JuliusC4es4r/Intelligent-Tidal-Energy-Monitoring-System/README.md

# Intelligent Tidal Energy Monitoring System
 A standalone smart tidal energy monitoring system designed to harvest energy from solar power and tidal waves while intelligently optimizing itself for maximum power generation and efficiency.
