JuliusC4es4r/Intelligent-Tidal-Energy-Monitoring-System/PSpice/ECE 356 HARDWARE.png

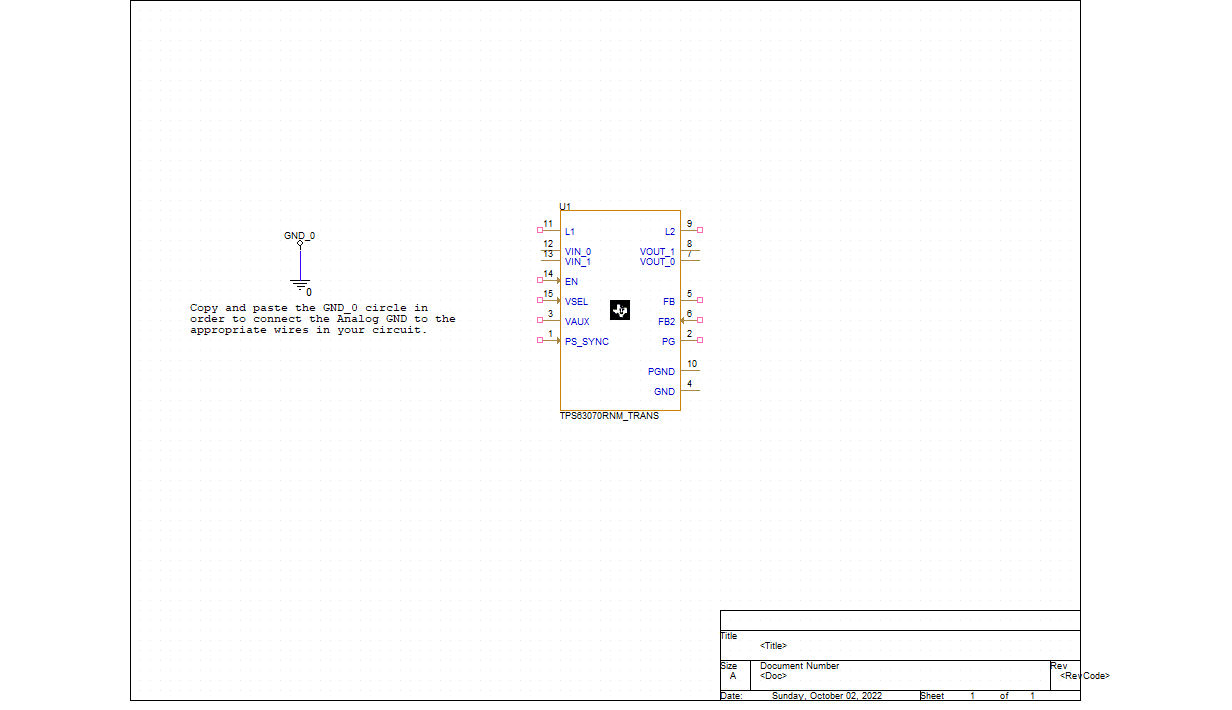
PSpice/ECE 356 HARDWARE.png
