JuliusC4es4r/Intelligent-Tidal-Energy-Monitoring-System/Electrical/Project Outputs for Intelligent Tidal Energy Monitoring System/BOM/BOM/Bill of Materials-Intelligent Tidal Energy Monitoring System(ITEMS PCBA Rev A).xlsx

Comment | Description | Designator | Footprint | LibRef | Quantity | Fitted
54 | Cylindrical Battery Contacts, Clips, Holders & Springs 16-19mm PC BATTERY CLIP | BT300 | FP-54-MFG | CMP-00051-1 | 1
0.1 µF | CAP CER 0.1UF 25V X7R 0603, CAP CER 0.1UF 50V X7R 0603 | C200, C201, C300, C301, C306, C310, C311, C402, C403 | CAP 0603_1608 | C0603X104M3RAC7867, C0603C104K5RAC7411 | 9
10 µF | CAP CER 10UF 25V X5R 0603 | C302, C303, C304, C307 | CAP 0603_1608 | GRM188R61E106MA73J | 4
22 µF | CAP CER 22UF 16V X5R 0805 | C305, C308, C309 | CAP 0805_2012 | CL21A226MOQNNNE | 3
0.022 µF | CAP CER 0.022UF 16V X7R 0603 | C400, C401 | CAP 0603_1608 | CC0603KRX7R7BB223 | 2
RBR2MM40CTFTR | DIODE (RECTIFIER FRD) 40V-VR 2A- | D300 | SOD123F | RBR2MM40CTFTR | 1
Green | LED GREEN CLEAR 2SMD | D301, D302 | LED 0603_1608 GREEN | XZVGT53W-6 | 2
LMV601MGX/NOPB | IC OPAMP GP 1 CIRCUIT SC70-6 | IC400, IC401 | TI SC70-6 DCK | LMV601MGX/NOPB | 2
B2B-XH-A(LF)(SN) | CONN HEADER VERT 2POS 2.5MM | J300 | JST XH B2B-XH-A | B2B-XH-A(LF)(SN) | 1
B3B-XH-A(LF)(SN) | CONN HEADER VERT 3POS 2.5MM | J400 | JST XH B3B-XH-A | B3B-XH-A(LF)(SN) | 1
GY-GPS6MV2 | NEO-6M GPS Module | J401 | GY-GPS6MV2 -Footprint-1 | CMP-00056-2 | 1
1.5µH | FIXED IND 1.5UH 1.5A 70 MOHM SMD | L300 | IND 1008_2520 | CVH252009-1R5M | 1
Exposed Mounting Hole M3 | M3 Mounting Hole Exposed | MH100, MH101, MH102, MH103 | Mounting Hole M3-Footprint-1 | CMP-00028-00002-1 | 4
BSS314PE | P-Channel OptiMOS P3 Small-Signal-Transistor, -30 V VDS, -1.5 A ID, -55 to 150 degC, PG-SOT23, Reel, Green | Q300 | INF-PG-SOT23_N | CMP-1099-00027-1 | 1
BSS126 | N-Channel SIPMOS Small-Signal-Transistor, 600 V VDS, 0.021 A ID, -55 to 150 degC, PG-SOT23, Reel, Green | Q301, Q302 | INF-PG-SOT23_L | CMP-1153-00007-1 | 2
10 kOhms | RES SMD 10K OHM 1% 1/10W 0603 | R200, R201, R302, R303, R305, R400 | RES 0603_1608 | RT0603FRE0710KL | 6
0 Ohms | RES 0 OHM JUMPER 1/10W 0603 | R300, R301 | RES 0603_1608 | PA0603-R-070RL | 2
300 kOhms | RES 300K OHM 1% 1/10W 0603 | R304 | RES 0603_1608 | RC0603FR-07300KL | 1
51 kOhms | RES SMD 51K OHM 1% 1/10W 0603 | R306 | RES 0603_1608 | CRCW060351K0FKEA | 1
3.3 kOhms | RES 3.3K OHM 1% 1/4W 0603 | R307 | RES 0603_1608 | CRGP0603F3K3 | 1
47k | THERMISTOR NTC 47KOHM 4050K 0603 | R308 | NTC 0603_1608 | NCP18WB473F10RB | 1
1 kOhms | RES SMD 1K OHM 1% 1/10W 0603 | R309, R310 | RES 0603_1608 | RT0603FRE071KL | 2
17.4 kOhms | RES 17.4K OHM 1% 1/10W 0603 | R401 | RES 0603_1608 | RC0603FR-0717K4L | 1
33 kOhms | RES SMD 33K OHM 1% 1/10W 0603 | R402, R403 | RES 0603_1608 | RT0603FRE0733KL | 2
1977223-9 | SWITCH TACTILE SPST-NO 0.05A 24V | S200, S201 | TE FSM4JSMA | 1977223-9 | 2
Rocker Switch | 12mm x 18.5mm Rocker Switch 6A 250VAC | S300, S301 | Rocker Switch-Footprint-1 | CMP-00054-3 | 2
1.5mm Test Point | 1.5mm Test Point 0.75mm hole size | TP200, TP303, TP304, TP305, TP306, TP400, TP401, TP402, TP403, TP404, TP405, TP406 | 1mm Test Point-Footprint-1 | CMP-002-00006-1 | 12
S2751-46R | Conn Test Point 1 POS Solder ST SMD 1 Port T/R | TP300, TP301, TP302, TP307 | FP-S2751-46R-MFG | CMP-00053-4 | 4
SC0918 | Raspberry Pi Pico W | U200 | New footprint 1 | CMP-00055-1 | 1
BQ25050DQCR | 1 A, Single-Input, Single Cell Li-Ion Battery Charger with 50 mA LDO, -40 to 85 degC, 10-pin WSON (DQC), Green (RoHS & no Sb/Br) | U300 | DQC0010A | CMP-0321-00476-2 | 1
TPS63070RNMR | IC REG BCK BST ADJ 3.6A 15VQFN | U301 | FP-RNM0015A-MFG | CMP-04918-000409-1 | 1
