JuliusC4es4r/Intelligent-Tidal-Energy-Monitoring-System/Mechanical/ITEMS Flow Sensor Assembly.SLDASM

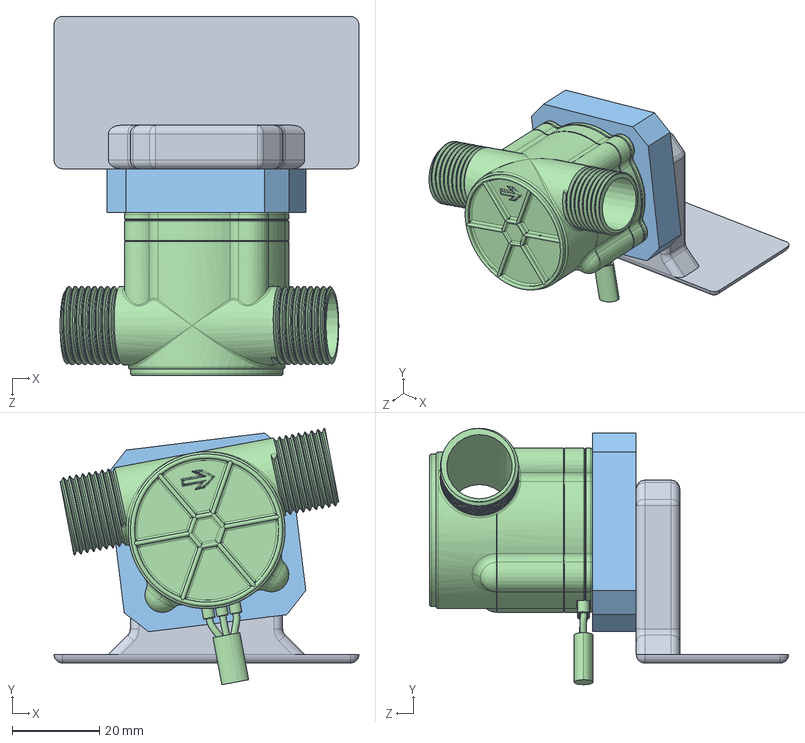
[picture p2: CAD file, 2022-11-04]
Mechanical/ITEMS Flow Sensor Assembly.SLDASM
70.0 x 58.9 x 82.5 mm
5972K222_Ball Bearing
Flow Sensor RotatorSLDPRT
Water Flow Sensor.STEP
pan cross head_ai_CR-PHMS 0.112-48x0.375x0.375-S.STEP x 4
