JuliusC4es4r/Intelligent-Tidal-Energy-Monitoring-System/Mechanical/ITEMS PCBA.SLDASM

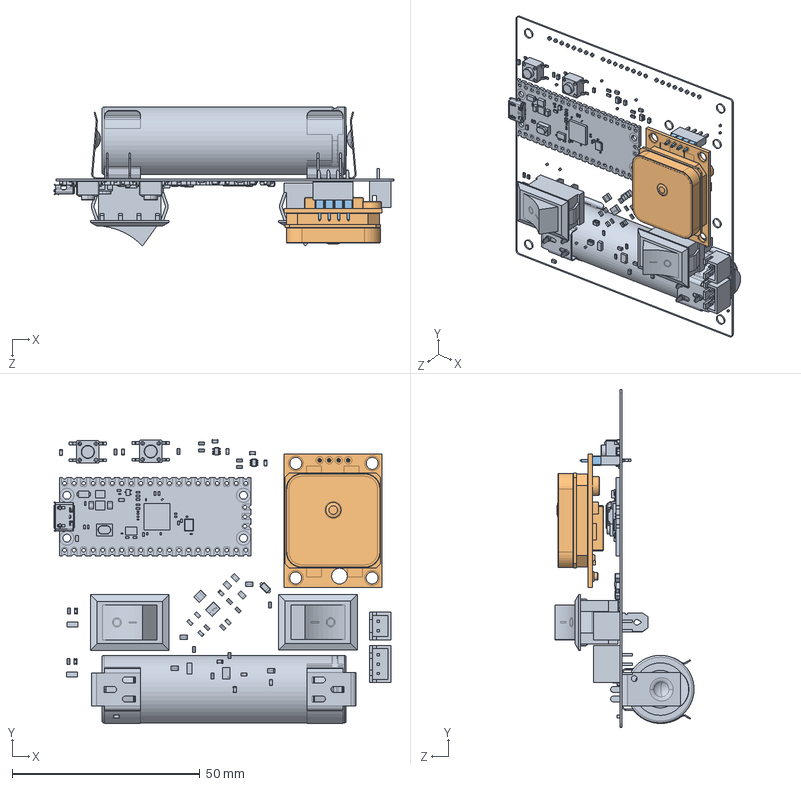
[picture p3: CAD file, 2022-10-14]
Mechanical/ITEMS PCBA.SLDASM
90.5 x 90.0 x 37.0 mm
ITEMS PCB Rev A
A_GPS_main
4-Pin Header - Male - 2.54mm.step
