JuliusC4es4r/Intelligent-Tidal-Energy-Monitoring-System/Mechanical/ITEMS Assembly.SLDASM

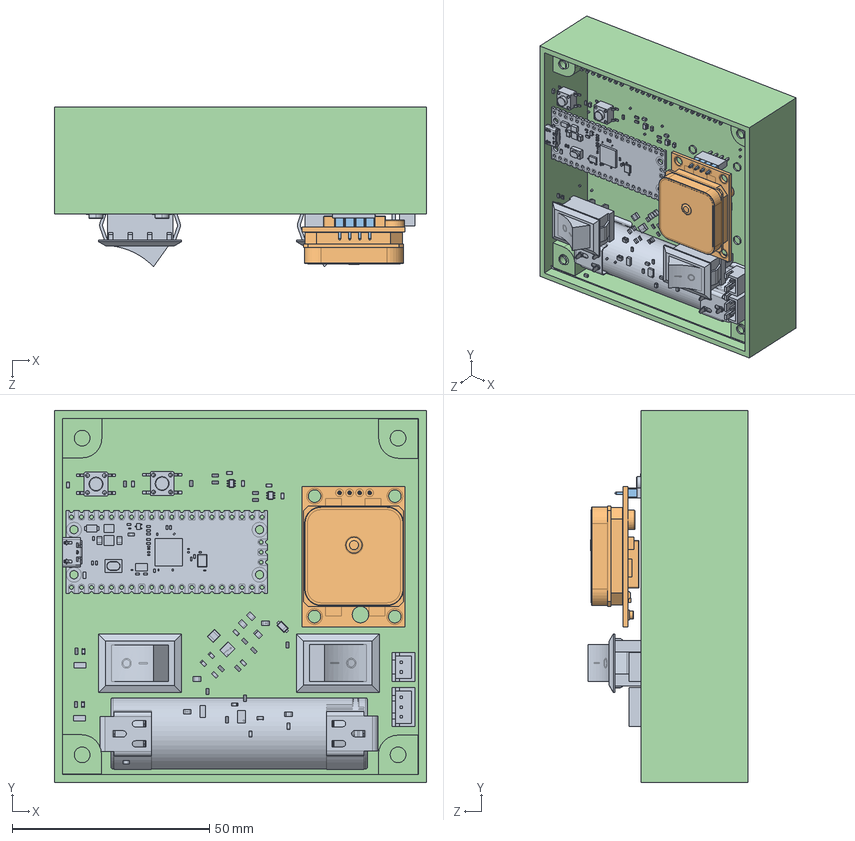
[picture p4: CAD file, 2022-10-13]
Mechanical/ITEMS Assembly.SLDASM
94.2 x 94.2 x 40.4 mm
ITEMS PCB Rev A
A_GPS_main
4-Pin Header - Male - 2.54mm.step
ITEMS Bottom Case
