JuliusC4es4r/Intelligent-Tidal-Energy-Monitoring-System/Mechanical/A_GPS_main.SLDPRT

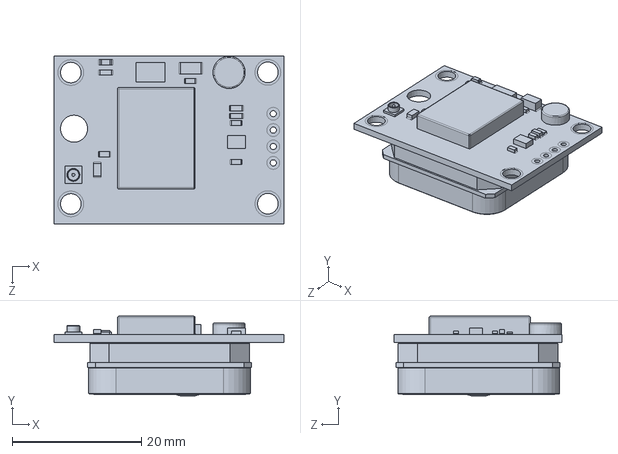
[picture p5: CAD file, 2022-10-07]
Mechanical/A_GPS_main.SLDPRT
35.6 x 12.3 x 26.1 mm
