JuliusC4es4r/Intelligent-Tidal-Energy-Monitoring-System/Mechanical/Flow Sensor RotatorSLDPRT.SLDPRT

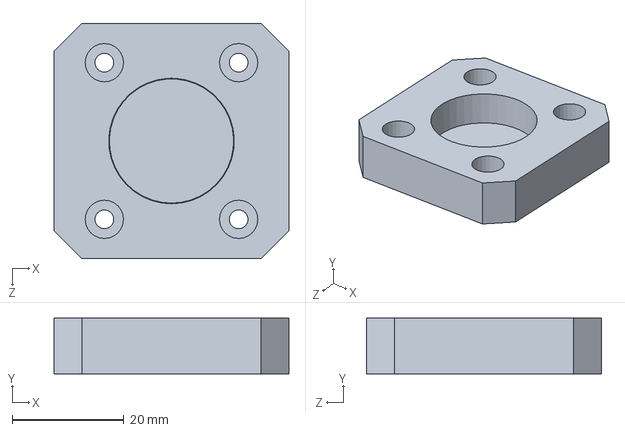
[picture p6: CAD file, 2022-11-06]
Mechanical/Flow Sensor RotatorSLDPRT.SLDPRT
42.0 x 10.0 x 42.0 mm
