JuliusC4es4r/Intelligent-Tidal-Energy-Monitoring-System/Mechanical/Flow Sensor Mount.SLDPRT

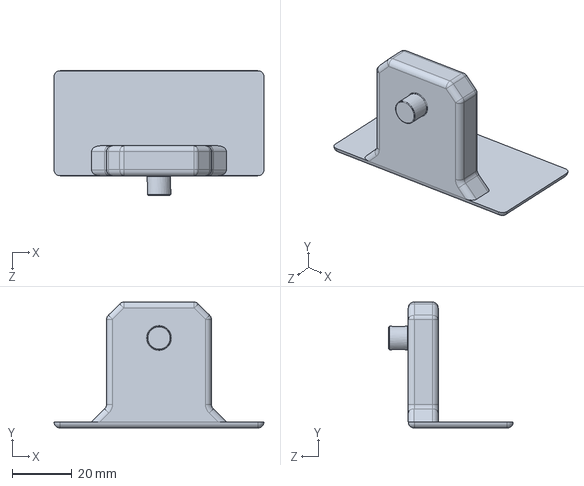
[picture p7: CAD file, 2022-11-04]
Mechanical/Flow Sensor Mount.SLDPRT
70.0 x 42.0 x 41.5 mm
