JuliusC4es4r/Intelligent-Tidal-Energy-Monitoring-System/Mechanical/Plexiglass Cutout 85mm squared.SLDPRT

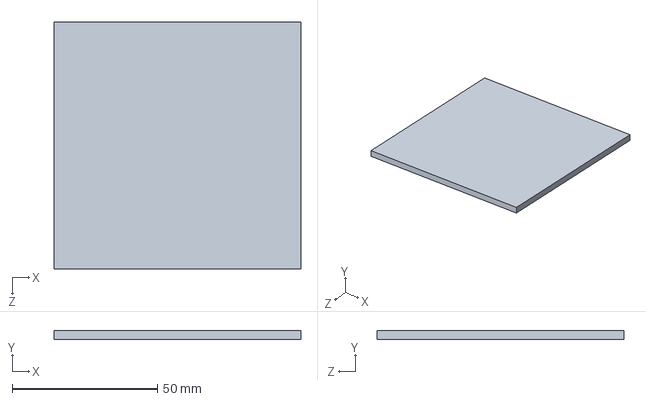
[picture p8: CAD file, 2022-11-04]
Mechanical/Plexiglass Cutout 85mm squared.SLDPRT
85.0 x 3.00 x 85.0 mm
