JuliusC4es4r/Intelligent-Tidal-Energy-Monitoring-System/Mechanical/ITEMS Bottom Case.SLDPRT

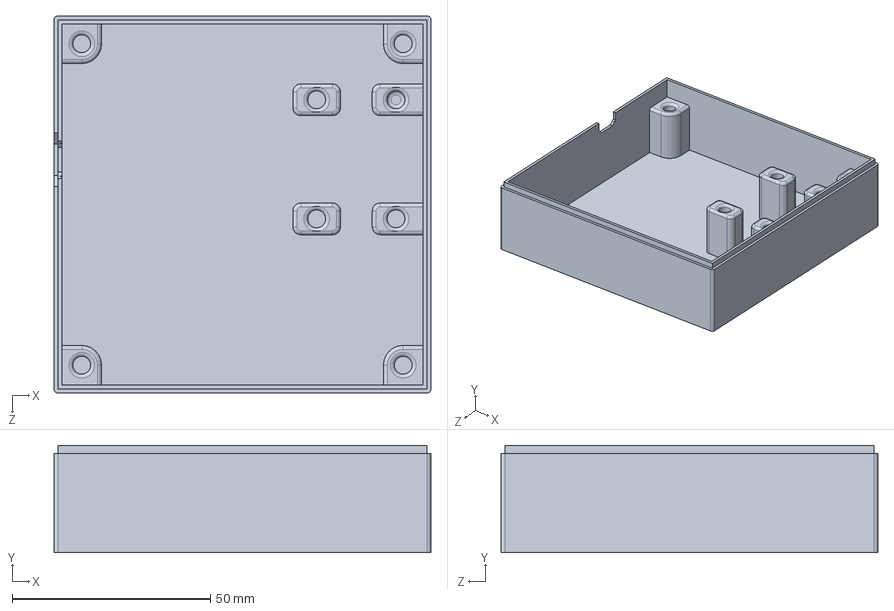
[picture p9: CAD file, 2022-11-04]
Mechanical/ITEMS Bottom Case.SLDPRT
95.0 x 27.0 x 95.0 mm
