JuliusC4es4r/Intelligent-Tidal-Energy-Monitoring-System/Mechanical/ITEMS Top Case.SLDPRT

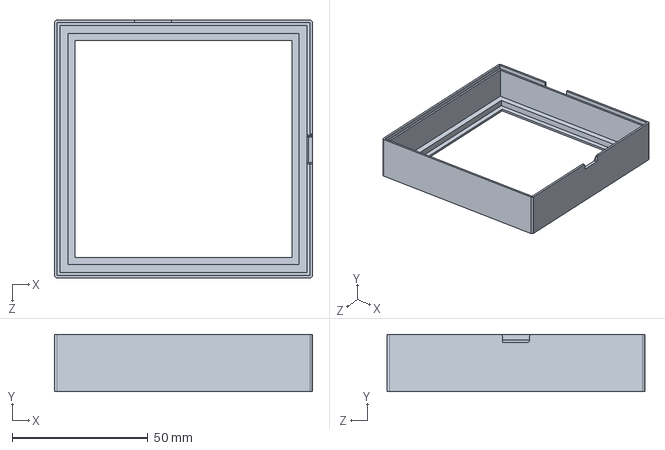
[picture p10: CAD file, 2022-11-04]
Mechanical/ITEMS Top Case.SLDPRT
95.0 x 21.0 x 95.0 mm
