JuliusC4es4r/Intelligent-Tidal-Energy-Monitoring-System/Mechanical/Water Flow sensor.STEP

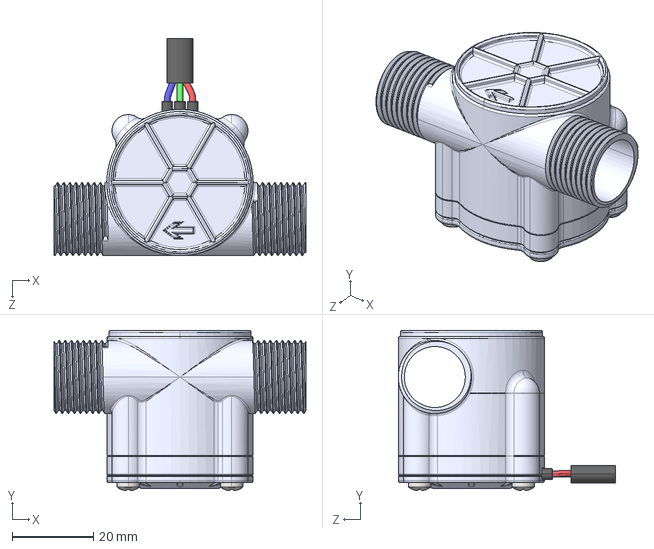
[picture p11: CAD file, 2022-11-04]
Mechanical/Water Flow sensor.STEP
62.0 x 39.5 x 53.5 mm
Water Flow Sensor
pan cross head_ai_CR-PHMS 0.112-48x0.375x0.375-S x 4
