JuliusC4es4r/Intelligent-Tidal-Energy-Monitoring-System/Mechanical/Solar Panel.SLDPRT

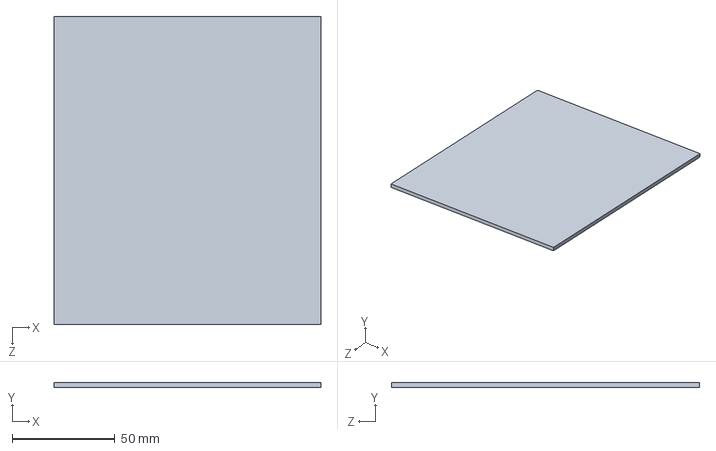
[picture p12: CAD file, 2022-10-13]
Mechanical/Solar Panel.SLDPRT
130.0 x 2.50 x 150.0 mm
