JuliusC4es4r/Intelligent-Tidal-Energy-Monitoring-System/Mechanical/4-Pin Header - Female - 2.54mm.step

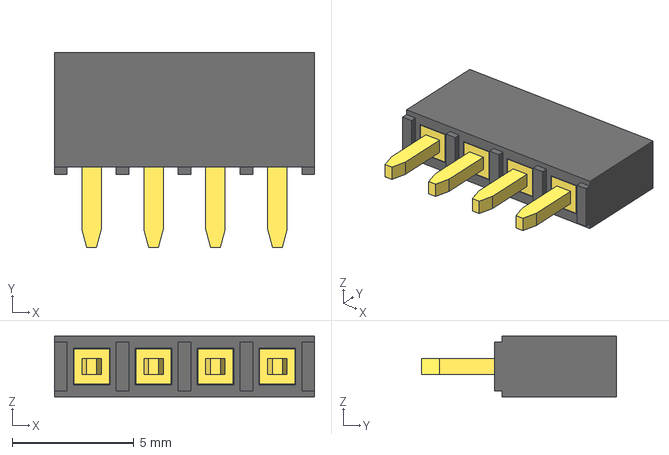
[picture p13: CAD file, 2022-10-07]
Mechanical/4-Pin Header - Female - 2.54mm.step
10.7 x 8.00 x 2.50 mm
