JuliusC4es4r/Intelligent-Tidal-Energy-Monitoring-System/Mechanical/4-Pin Header - Male - 2.54mm.step

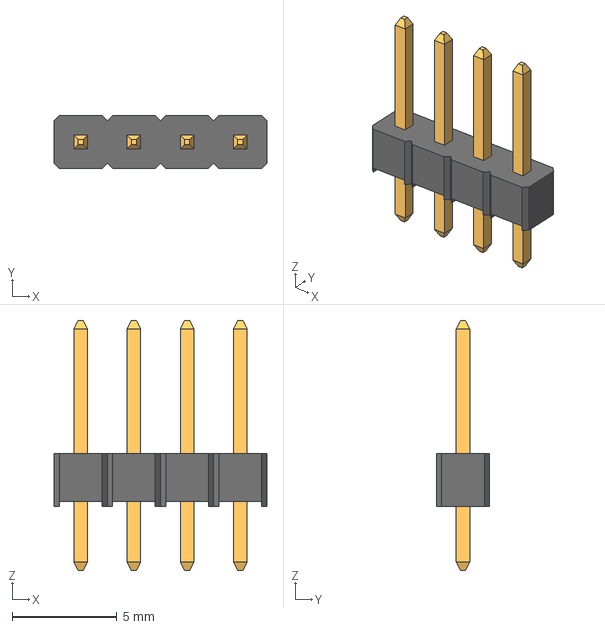
[picture p14: CAD file, 2022-10-07]
Mechanical/4-Pin Header - Male - 2.54mm.step
10.2 x 2.54 x 11.9 mm
