JuliusC4es4r/Intelligent-Tidal-Energy-Monitoring-System/Mechanical/5972K222_Ball Bearing.SLDPRT

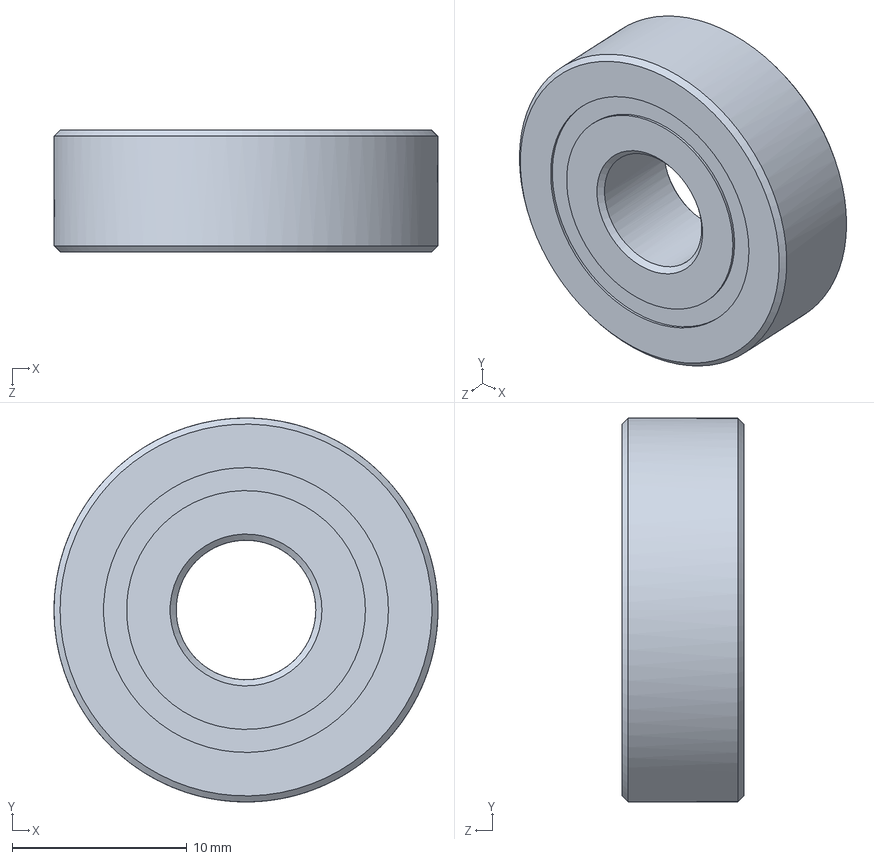
[picture p15: CAD file, 2022-11-04]
Mechanical/5972K222_Ball Bearing.SLDPRT
22.0 x 22.0 x 7.00 mm
