JuliusC4es4r/Intelligent-Tidal-Energy-Monitoring-System/Mechanical/91290A111_Alloy Steel Socket Head Screw.SLDPRT

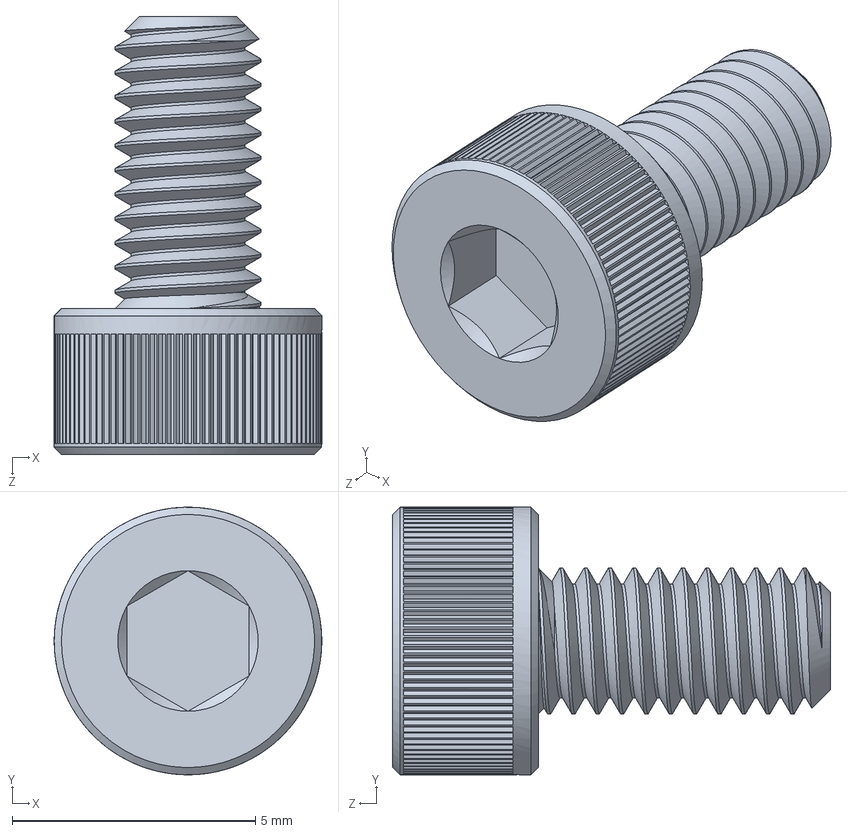
[picture p16: CAD file, 2022-10-14]
Mechanical/91290A111_Alloy Steel Socket Head Screw.SLDPRT
5.50 x 5.50 x 9.00 mm
