JuliusC4es4r/Intelligent-Tidal-Energy-Monitoring-System/Mechanical/94459A140_Heat-Set Inserts for Plastic (1).SLDPRT

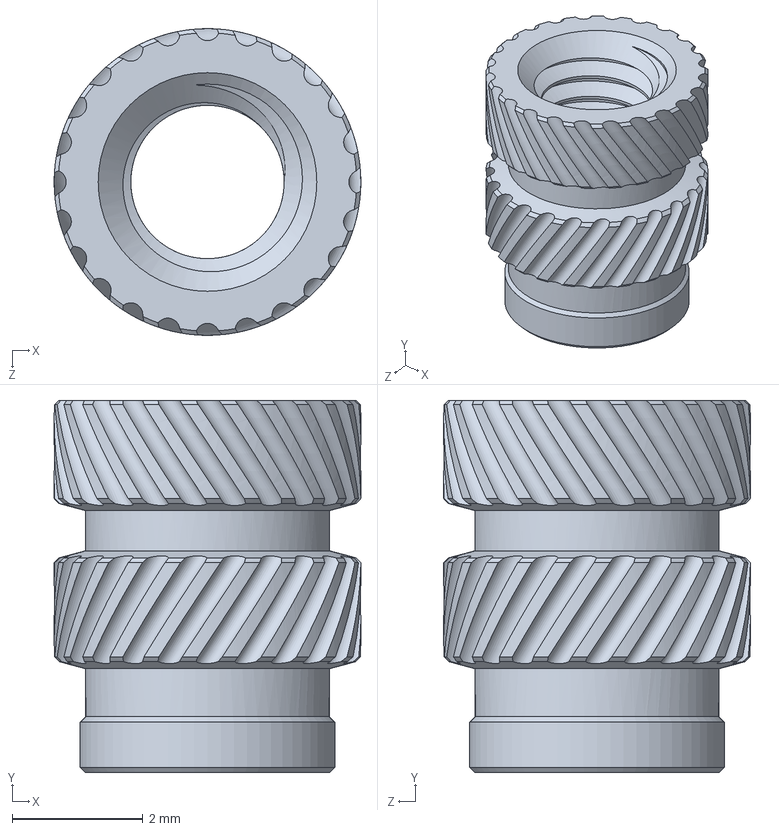
[picture p17: CAD file, 2022-10-14]
Mechanical/94459A140_Heat-Set Inserts for Plastic (1).SLDPRT
4.70 x 5.70 x 4.70 mm
