JuliusC4es4r/Intelligent-Tidal-Energy-Monitoring-System/(list of files, cad)

Other CAD files:
Mechanical/Flow Sensor Mount.STL
Mechanical/Flow Sensor RotatorSLDPRT.STL
Mechanical/ITEMS Bottom Case.STL
Mechanical/ITEMS Top Case.STL
