JuliusC4es4r/Intelligent-Tidal-Energy-Monitoring-System/Electrical/Intelligent Tidal Energy Monitoring System.pdf

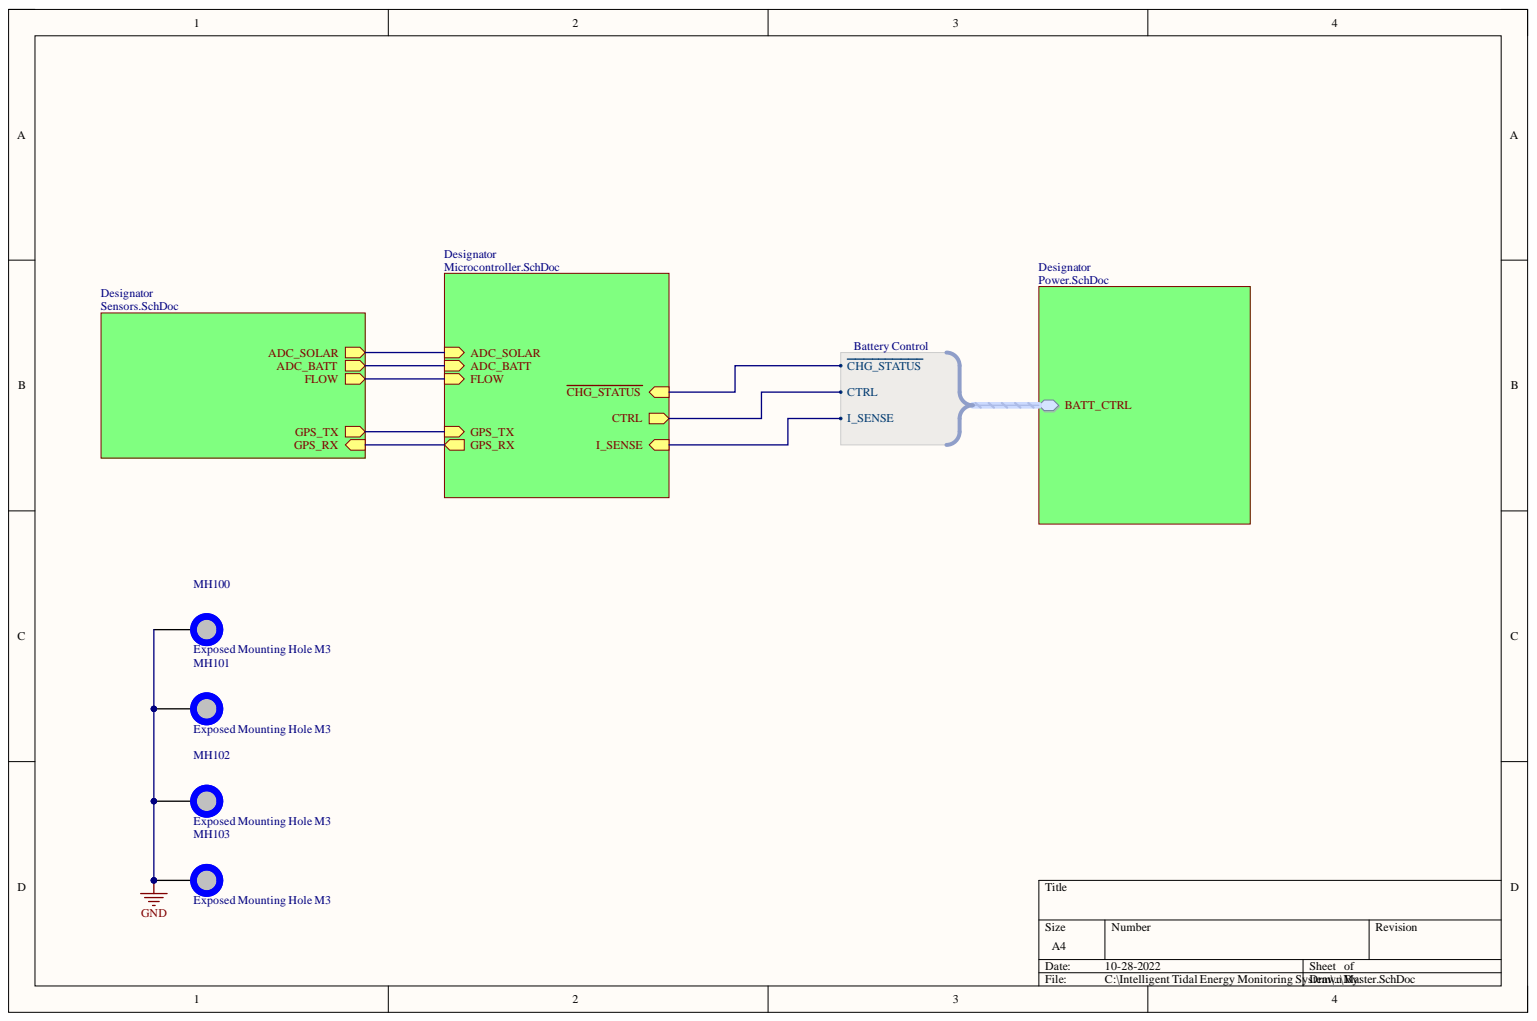
[picture p18: page 1]

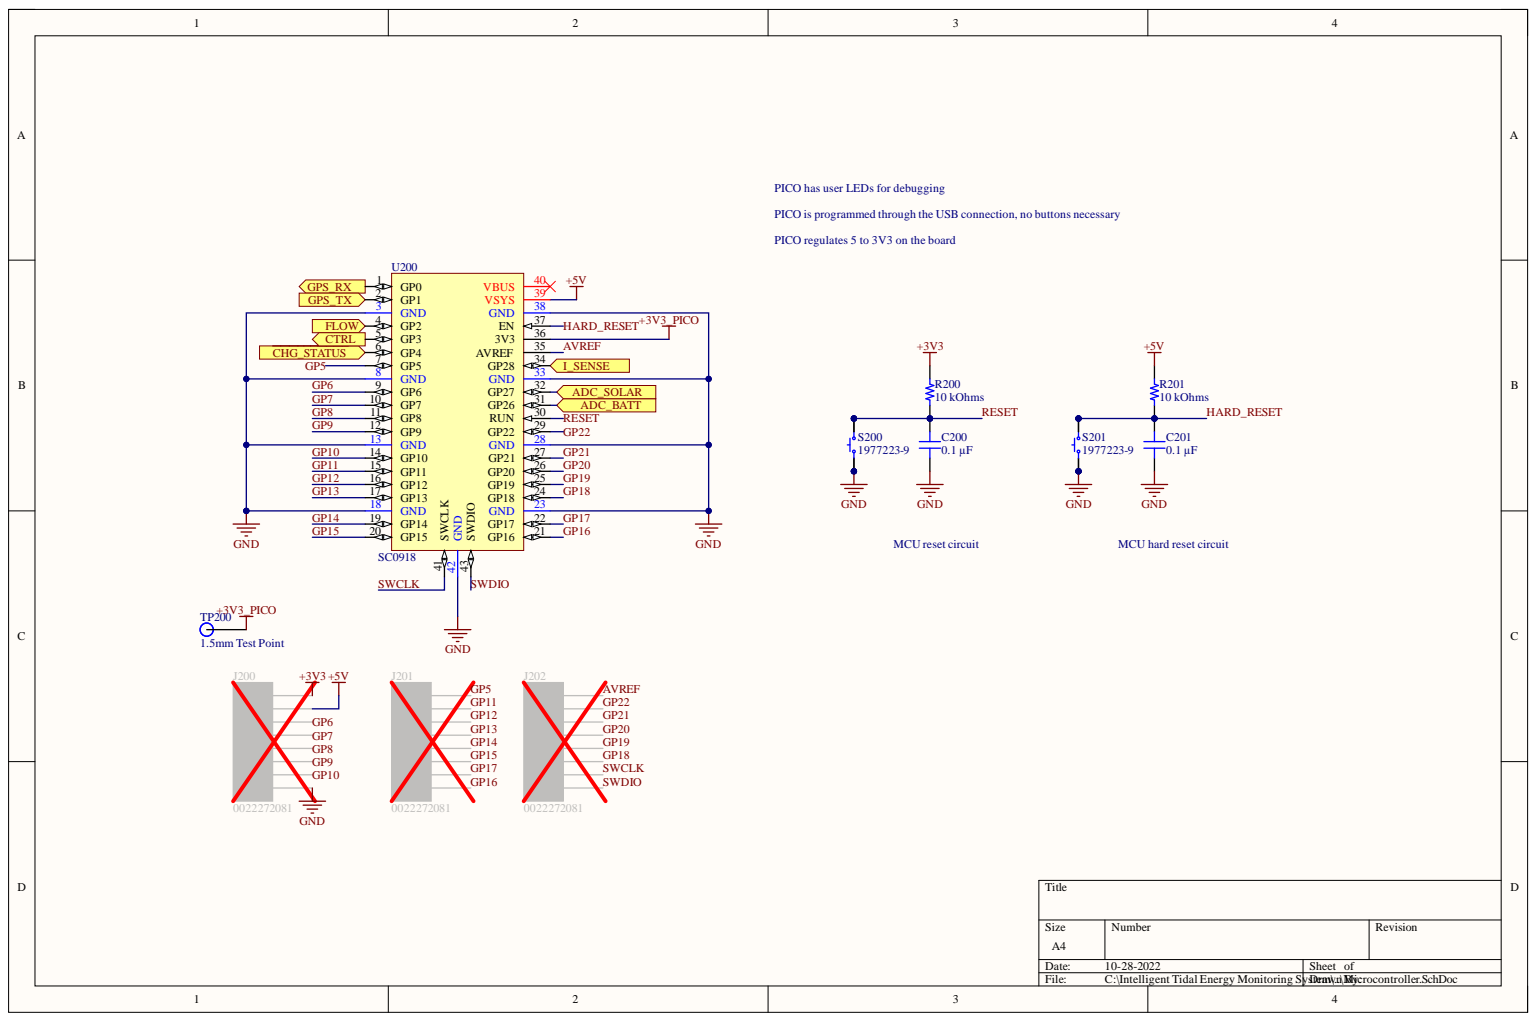
[picture p19: page 2]

FL O W CTRL CH G_ST AT | 4 | VA 3 7 +3 V 3 _PI C O

5 | 3 6
6 | 3 5 AV RE F I_SE N S E

1 2 | | 2
1 3 | | 2 8

sDtem\ raw..\nMi Bycro : co

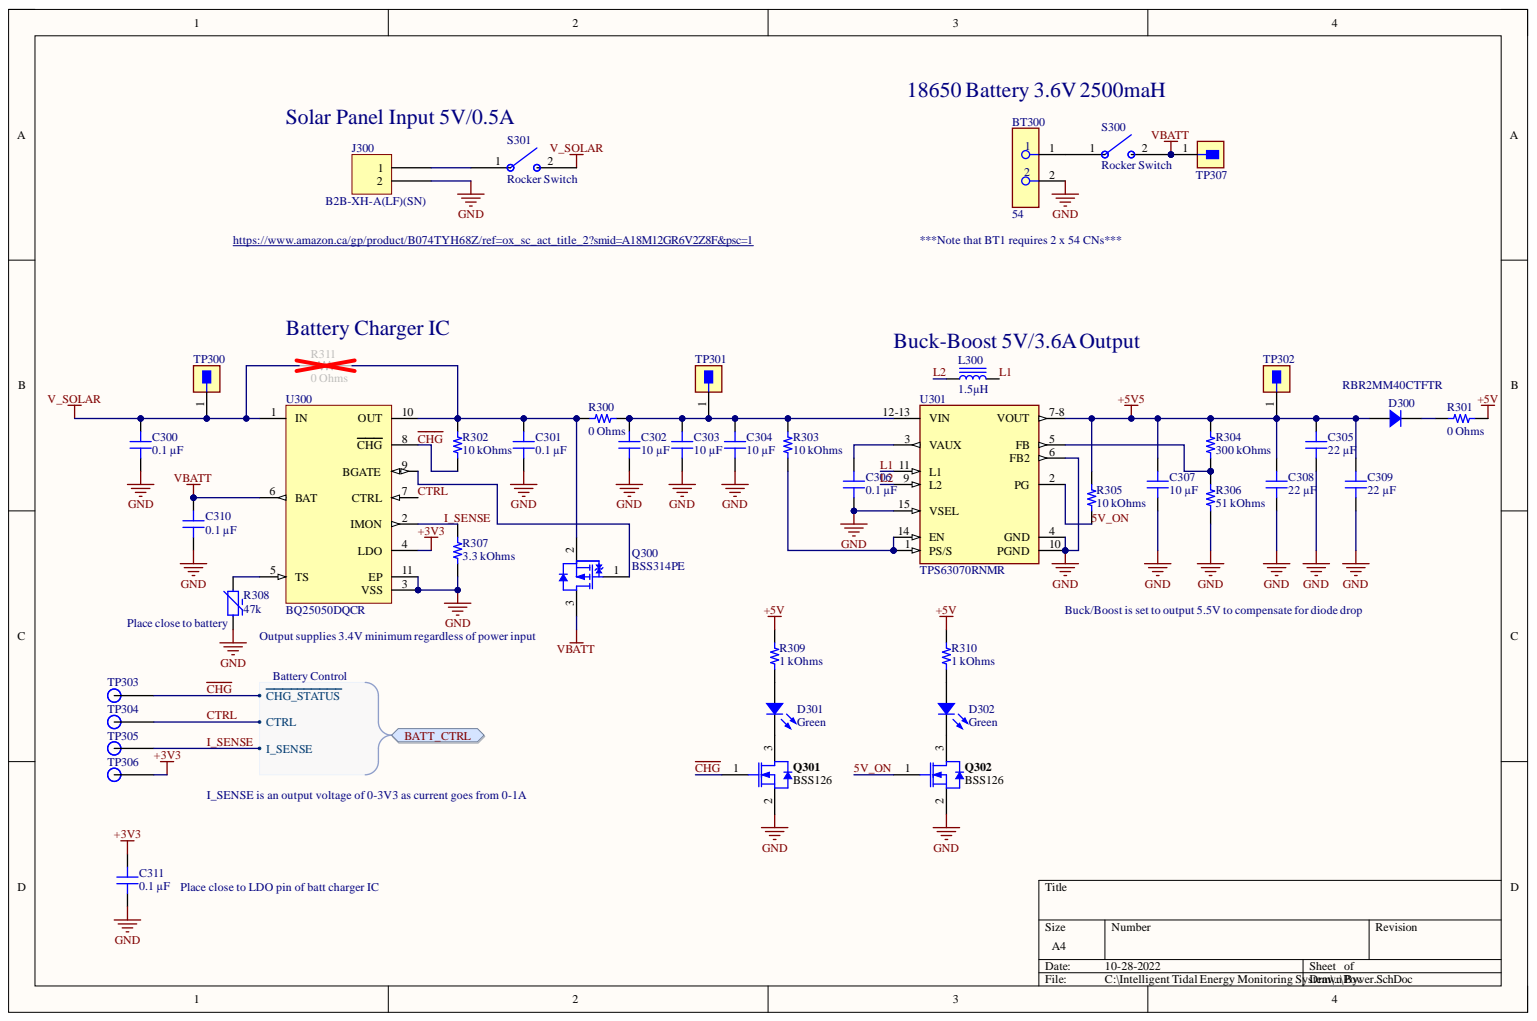
[picture p20: page 3]

https://www.amazon.ca/gp/product/B074TYH68Z/ref=ox_sc_act_title_2?smid=A18M12GR6V2Z8F&psc=1

***Note that BT1 requires 2 x 54 CNs***

Buck/Boost is set to output 5.5V to compensate for diode drop

Place close to battery

Output supplies 3.4V minimum regardless of power input

I_SENSE is an output voltage of 0-3V3 as current goes from 0-1A

Place close to LDO pin of batt charger IC

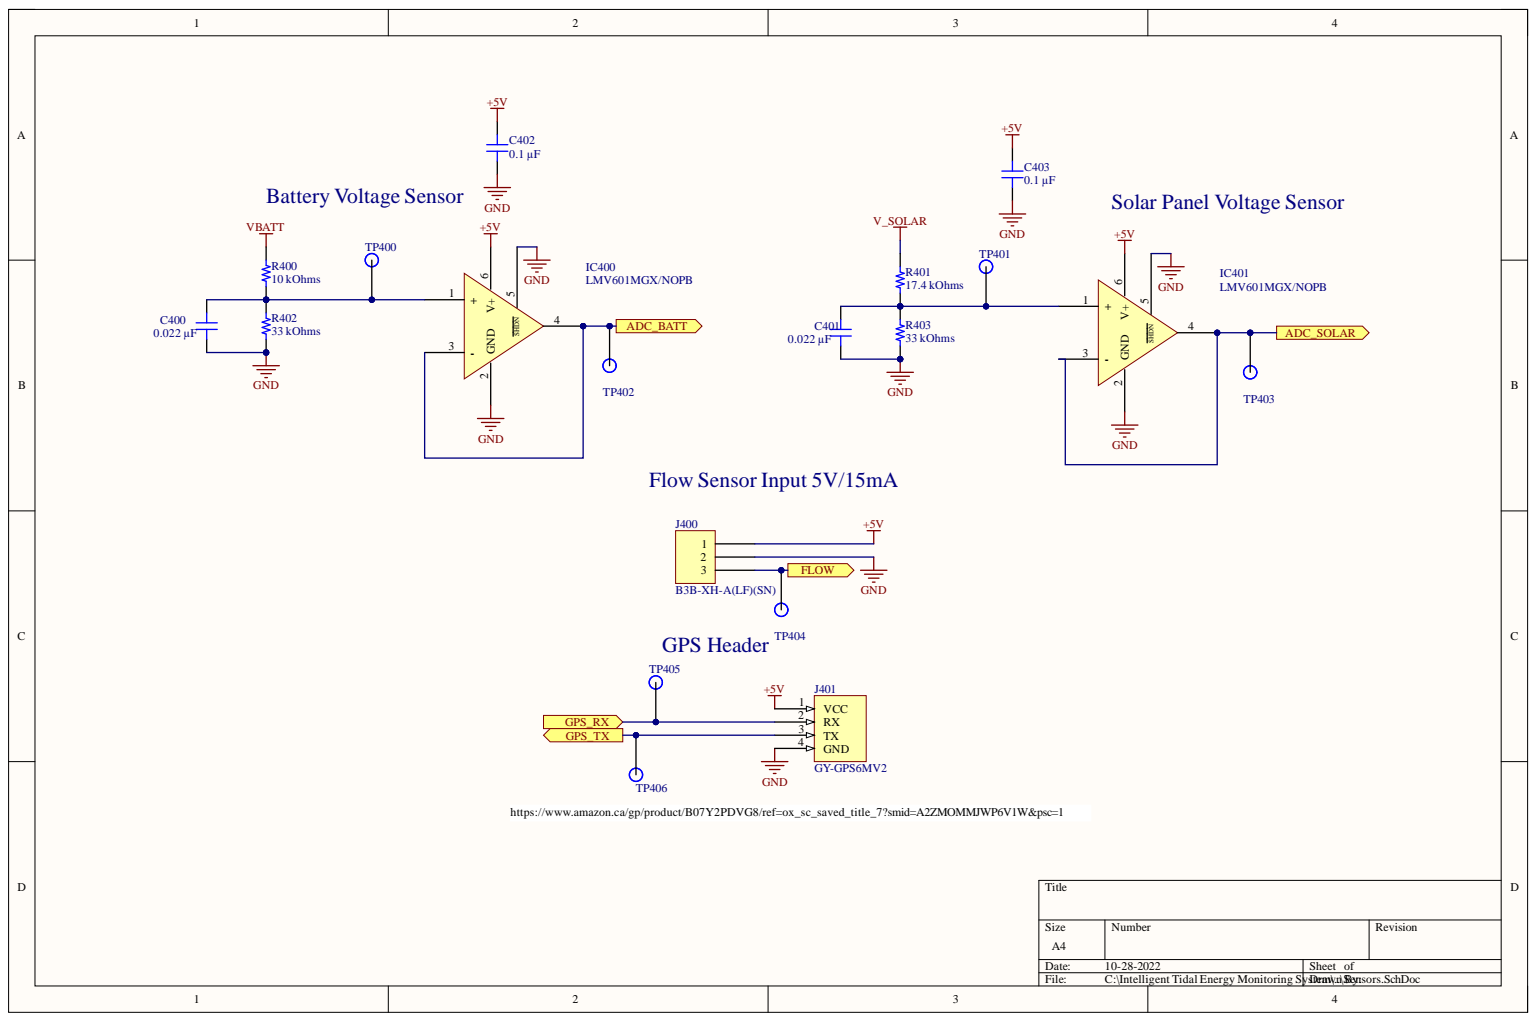
[picture p21: page 4]

Solar Panel Voltage Sensor

https://www.amazon.ca/gp/product/B07Y2PDVG8/ref=ox_sc_saved_title_7?smid=A2ZMOMMJWP6V1W&psc=1

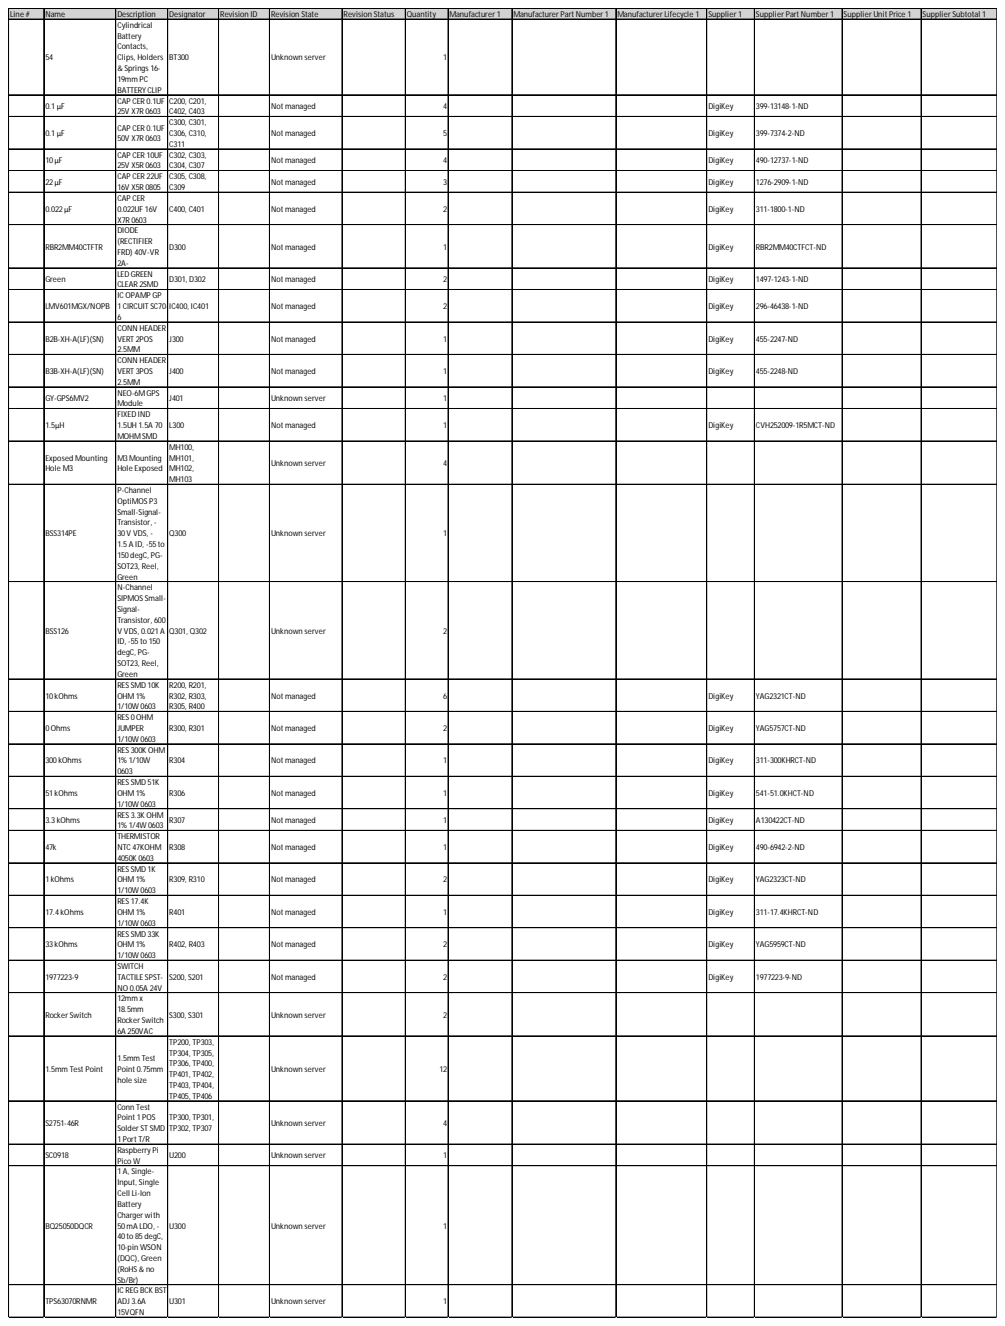
[picture p22: page 5]

Line # | Name | Description | Designator | Revision ID | Revision State | Revision Status | Quantity | Manufacturer 1 | Manufacturer Part Number 1 | Manufacturer Lifecycle 1 | Supplier 1 | Supplier Part Number 1 | Supplier Unit Price 1 | Supplier Subtotal 1

Cylindrical Battery Contacts, Clips, Holders & Springs 16-19mm PC BATTERY CLIP | BT300 | | Unknown server | | | 1

0.1 µF | CAP CER 0.1UF 25V X7R 0603 | C200, C201, C402, C403 | | Not managed | | | 4 | | | DigiKey | 399-13148-1-ND

0.1 µF | CAP CER 0.1UF 50V X7R 0603 | C300, C301, C306, C310, C311 | | Not managed | | | 5 | | | DigiKey | 399-7374-2-ND

10 µF | CAP CER 10UF 25V X5R 0603 | C302, C303, C304, C307 | | Not managed | | | 4 | | | DigiKey | 490-12737-1-ND

22 µF | CAP CER 22UF 16V X5R 0805 | C305, C308, C309 | | Not managed | | | 3 | | | DigiKey | 1276-2909-1-ND

0.022 µF | CAP CER 0.022UF 16V X7R 0603 | C400, C401 | | Not managed | | | 2 | | | DigiKey | 311-1800-1-ND

RBR2MM40CTFTR | DIODE (RECTIFIER FRD) 40V-VR 2A- | D300 | | Not managed | | | 1 | | | DigiKey | RBR2MM40CTFCT-ND

Green | LED GREEN CLEAR 2SMD | D301, D302 | | Not managed | | | 2 | | | DigiKey | 1497-1243-1-ND

LMV601MGX/NOPB | IC OPAMP GP 1 CIRCUIT SC70-6 | IC400, IC401 | | Not managed | | | 2 | | | DigiKey | 296-46438-1-ND

B2B-XH-A(LF)(SN) | CONN HEADER VERT 2POS 2.5MM | J300 | | Not managed | | | 1 | | | DigiKey | 455-2247-ND

B3B-XH-A(LF)(SN) | CONN HEADER VERT 3POS 2.5MM | J400 | | Not managed | | | 1 | | | DigiKey | 455-2248-ND

GY-GPS6MV2 | NEO-6M GPS Module | J401 | | Unknown server | | | 1

1.5µH | FIXED IND 1.5UH 1.5A 70 MOHM SMD | L300 | | Not managed | | | 1 | | | DigiKey | CVH252009-1R5MCT-ND

Exposed Mounting Hole M3 | M3 Mounting Hole Exposed | MH100, MH101, MH102, MH103 | | Unknown server | | | 4

BSS314PE | P-Channel OptiMOS P3 Small-Signal-Transistor, -30 V VDS, -1.5 A ID, -55 to 150 degC, PG-SOT23, Reel, Green | Q300 | | Unknown server | | | 1

BSS126 | N-Channel SIPMOS Small-Signal-Transistor, 600 V VDS, 0.021 A ID, -55 to 150 degC, PG-SOT23, Reel, Green | Q301, Q302 | | Unknown server | | | 2

10 kOhms | RES SMD 10K OHM 1% 1/10W 0603 | R200, R201, R302, R303, R305, R400 | | Not managed | | | 6 | | | DigiKey | YAG2321CT-ND

0Ohms | RES 0OHM JUMPER 1/10W 0603 | R300, R301 | | Not managed | | | 2 | | | DigiKey | YAG5757CT-ND

300 kOhms | RES 300K OHM 1% 1/10W 0603 | R304 | | Not managed | | | 1 | | | DigiKey | 311-300KHRCT-ND

51 kOhms | RES SMD 51K OHM 1% 1/10W 0603 | R306 | | Not managed | | | 1 | | | DigiKey | 541-51.0KHCT-ND

3.3 kOhms | RES 3.3K OHM 1% 1/4W 0603 | R307 | | Not managed | | | 1 | | | DigiKey | A130422CT-ND

47k | THERMISTOR NTC 47KOHM 4050K 0603 | R308 | | Not managed | | | 1 | | | DigiKey | 490-6942-2-ND

1 kOhms | RES SMD 1K OHM 1% 1/10W 0603 | R309, R310 | | Not managed | | | 2 | | | DigiKey | YAG2323CT-ND

17.4 kOhms | RES 17.4K OHM 1% 1/10W 0603 | R401 | | Not managed | | | 1 | | | DigiKey | 311-17.4KHRCT-ND

33 kOhms | RES SMD 33K OHM 1% 1/10W 0603 | R402, R403 | | Not managed | | | 2 | | | DigiKey | YAG5959CT-ND

1977223-9 | SWITCH TACTILE SPST-NO 0.05A 24V | S200, S201 | | Not managed | | | 2 | | | DigiKey | 1977223-9-ND

Rocker Switch | 12mm x 18.5mm Rocker Switch 6A 250VAC | S300, S301 | | Unknown server | | | 2

1.5mm Test Point | 1.5mm Test Point 0.75mm hole size | TP200, TP303, TP304, TP305, TP306, TP400, TP401, TP402, TP403, TP404, TP405, TP406 | | Unknown server | | 12

S2751-46R | Conn Test Point 1 POS Solder ST SMD 1 Port T/R | TP300, TP301, TP302, TP307 | | Unknown server | | | 4

SC0918 | Raspberry Pi Pico W | U200 | | Unknown server | | | 1

BQ25050DQCR | 1 A, Single-Input, Single Cell Li-Ion Battery Charger with 50mA LDO, -40 to 85 degC, 10-pin WSON (DQC), Green (RoHS & no Sb/Br) | U300 | | Unknown server | | | 1

TPS63070RNMR | IC REG BCK BST ADJ 3.6A 15VQFN | U301 | | Unknown server | | | 1
