JuliusC4es4r/Intelligent-Tidal-Energy-Monitoring-System/Electrical/Project Outputs for Intelligent Tidal Energy Monitoring System/PDF Files/ITEMS Output.PDF

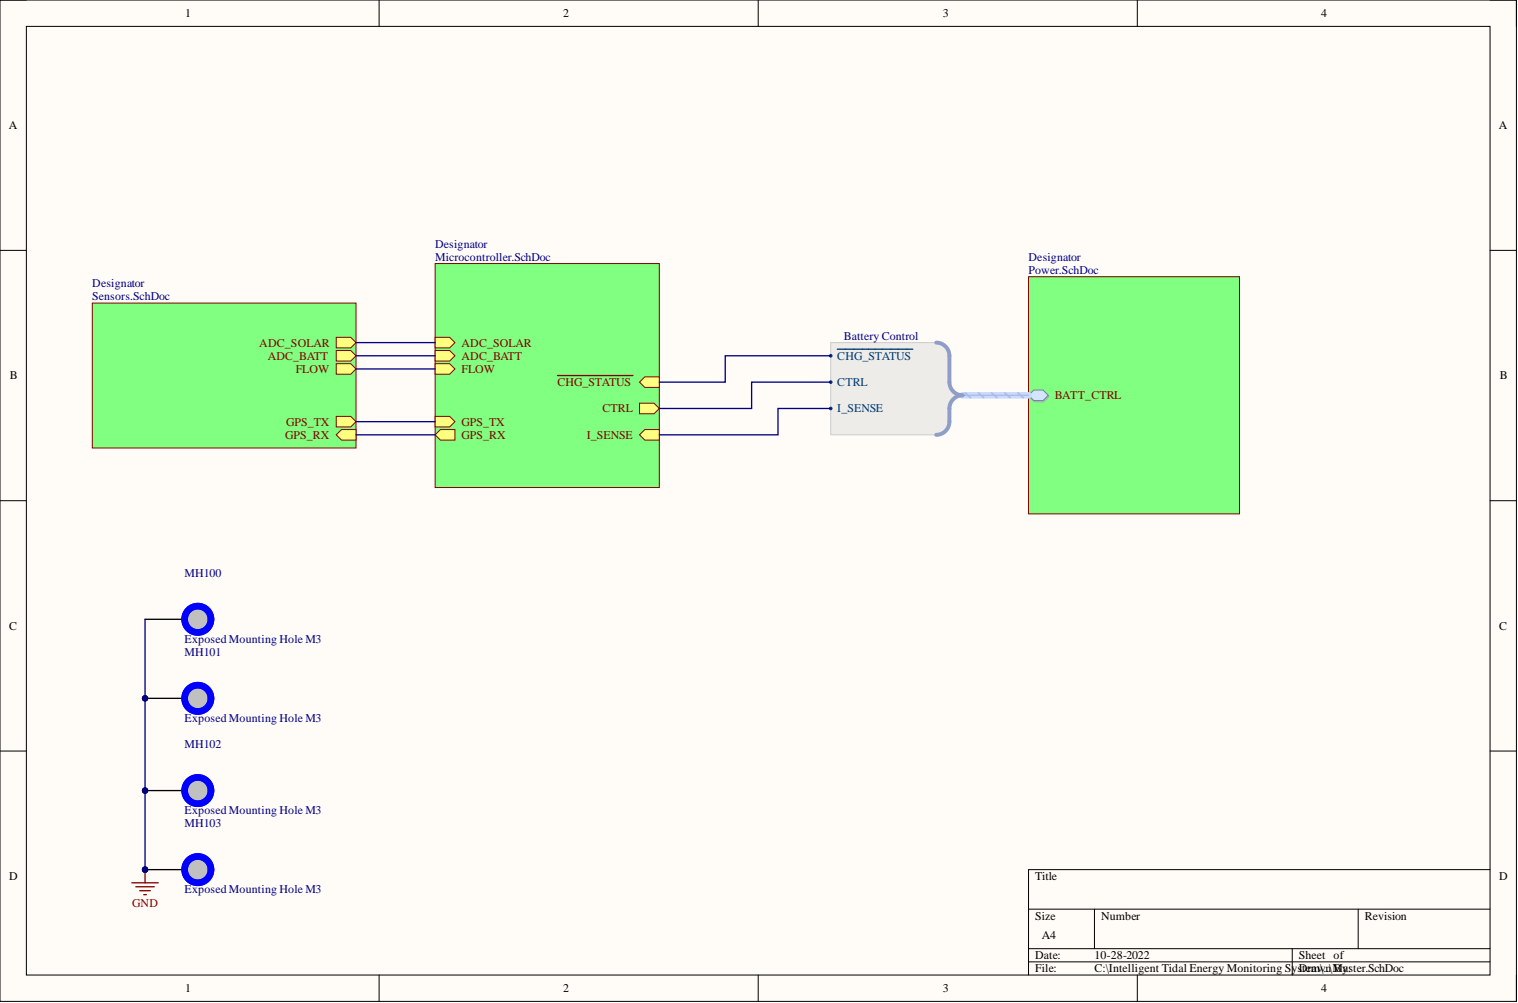
[picture p23: page 1]

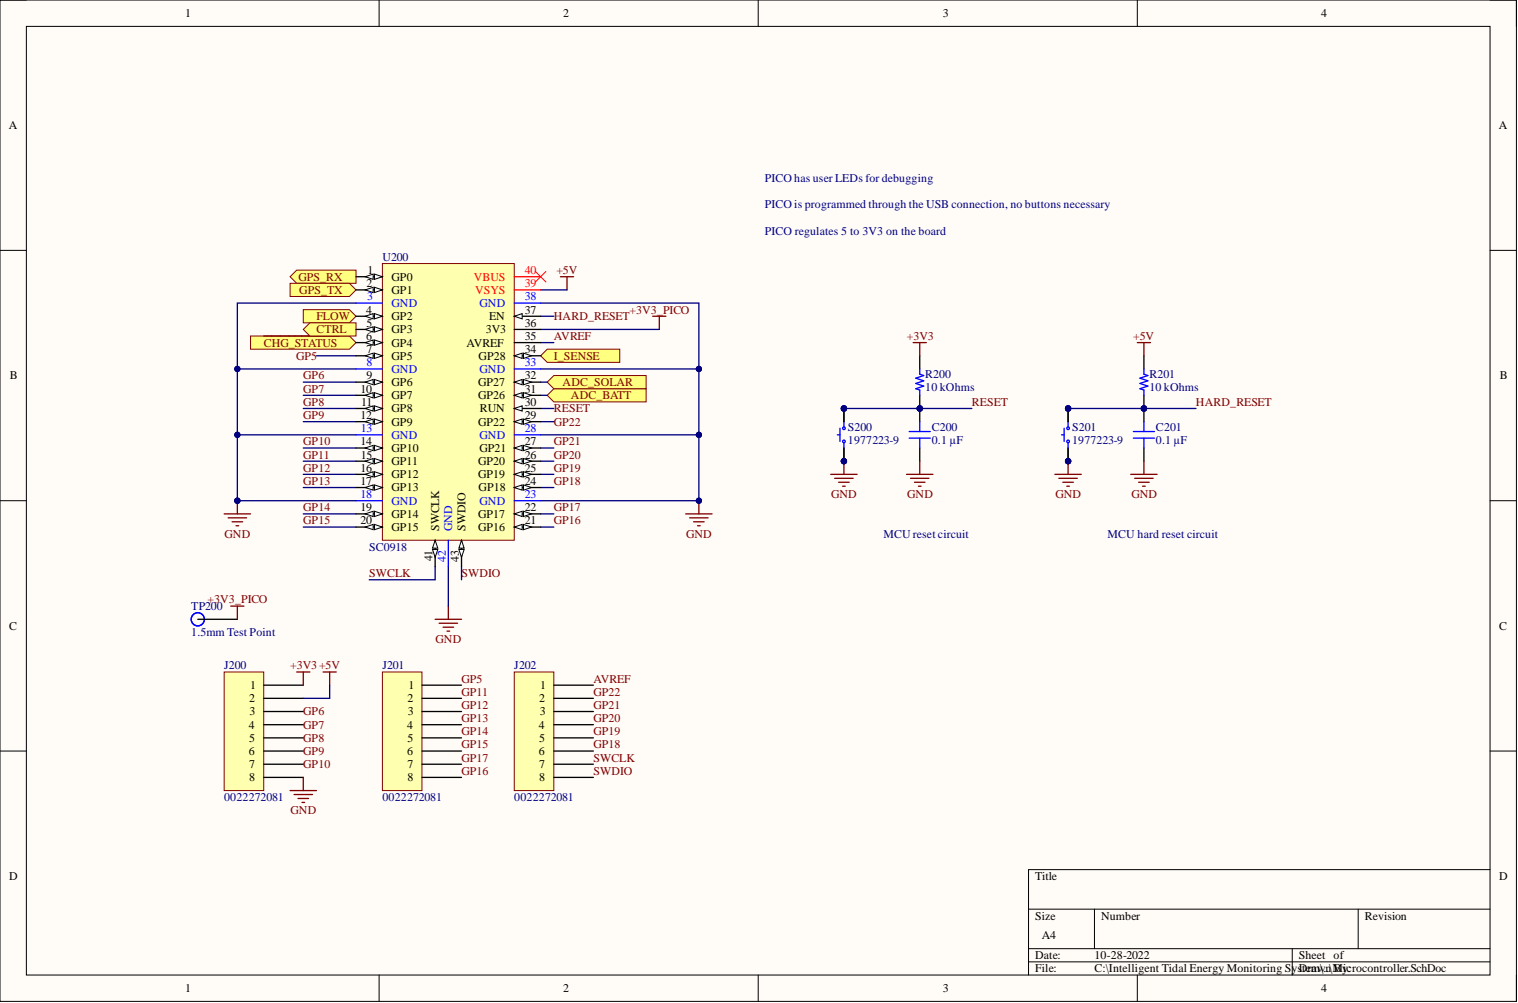
[picture p24: page 2]

FL O W CTRL CH G_ST AT | 4 | VA 3 7 +3 V 3 _PI C O

5 | 3 6
6 | 3 5 AV RE F I_SE N S E

1 2 | | 2
1 3 | | 2 8

sDtem\ raw..\nMi Bycro : co

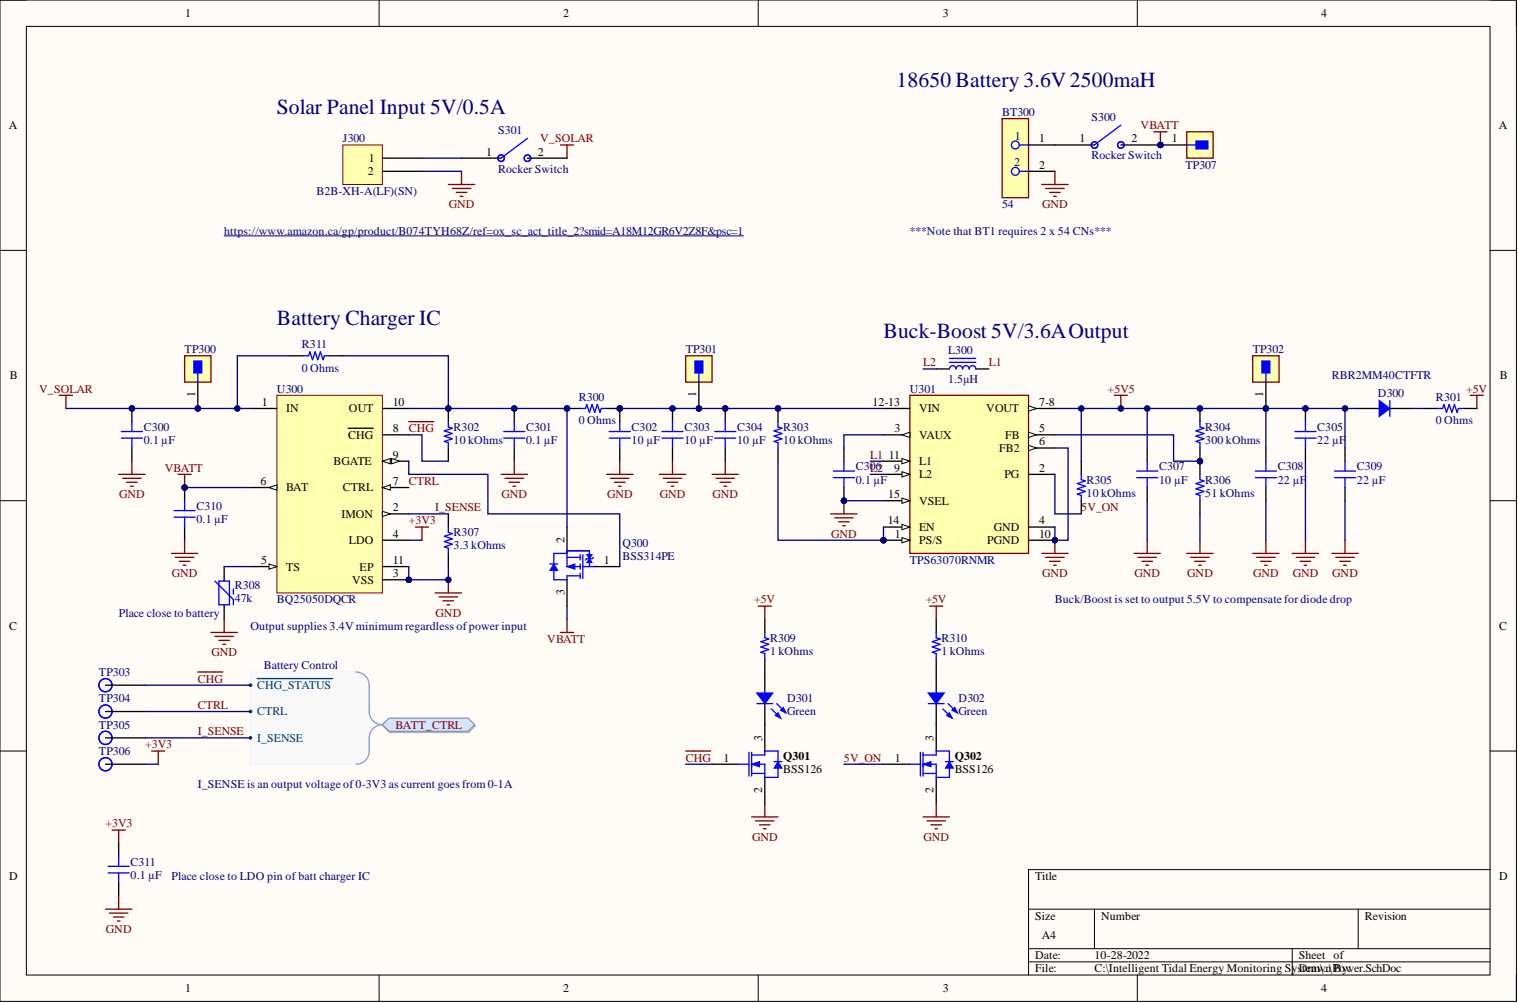
[picture p25: page 3]

https://www.amazon.ca/gp/product/B074TYH68Z/ref=ox_sc_act_title_2?smid=A18M12GR6V2Z8F&psc=1

***Note that BT1 requires 2 x 54 CNs***

Place close to battery

Buck/Boost is set to output 5.5V to compensate for diode drop

Output supplies 3.4V minimum regardless of power input

I_SENSE is an output voltage of 0-3V3 as current goes from 0-1A

Place close to LDO pin of batt charger IC

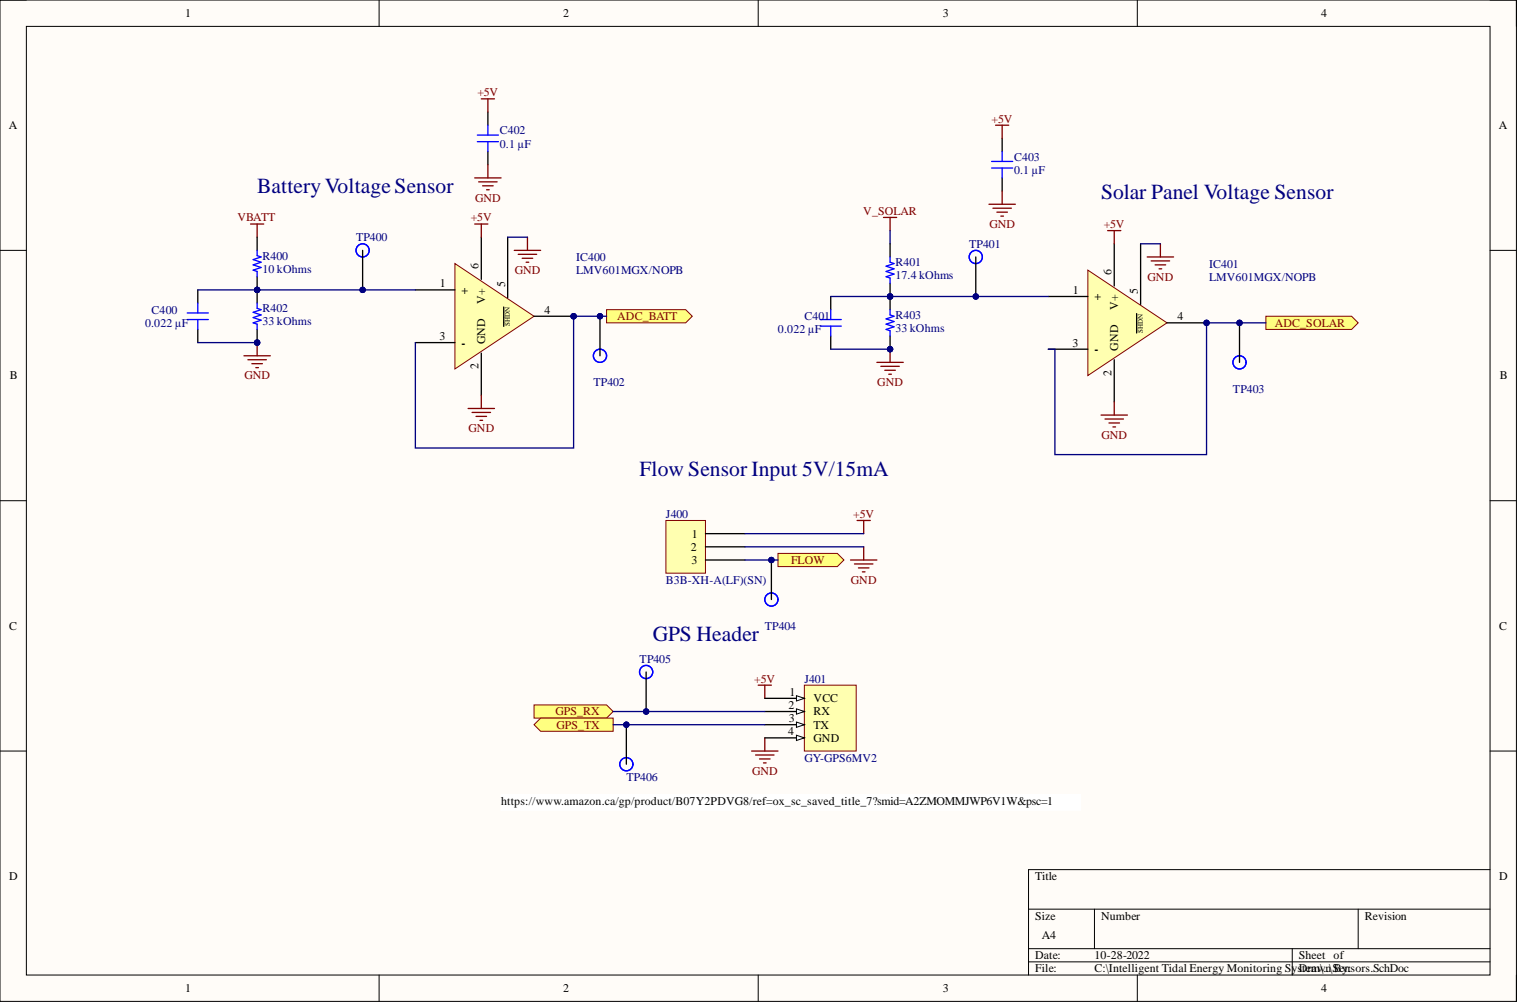
[picture p26: page 4]

Solar Panel Voltage Sensor

https://www.amazon.ca/gp/product/B07Y2PDVG8/ref=ox_sc_saved_title_7?smid=A2ZMOMMJWP6V1W&psc=1

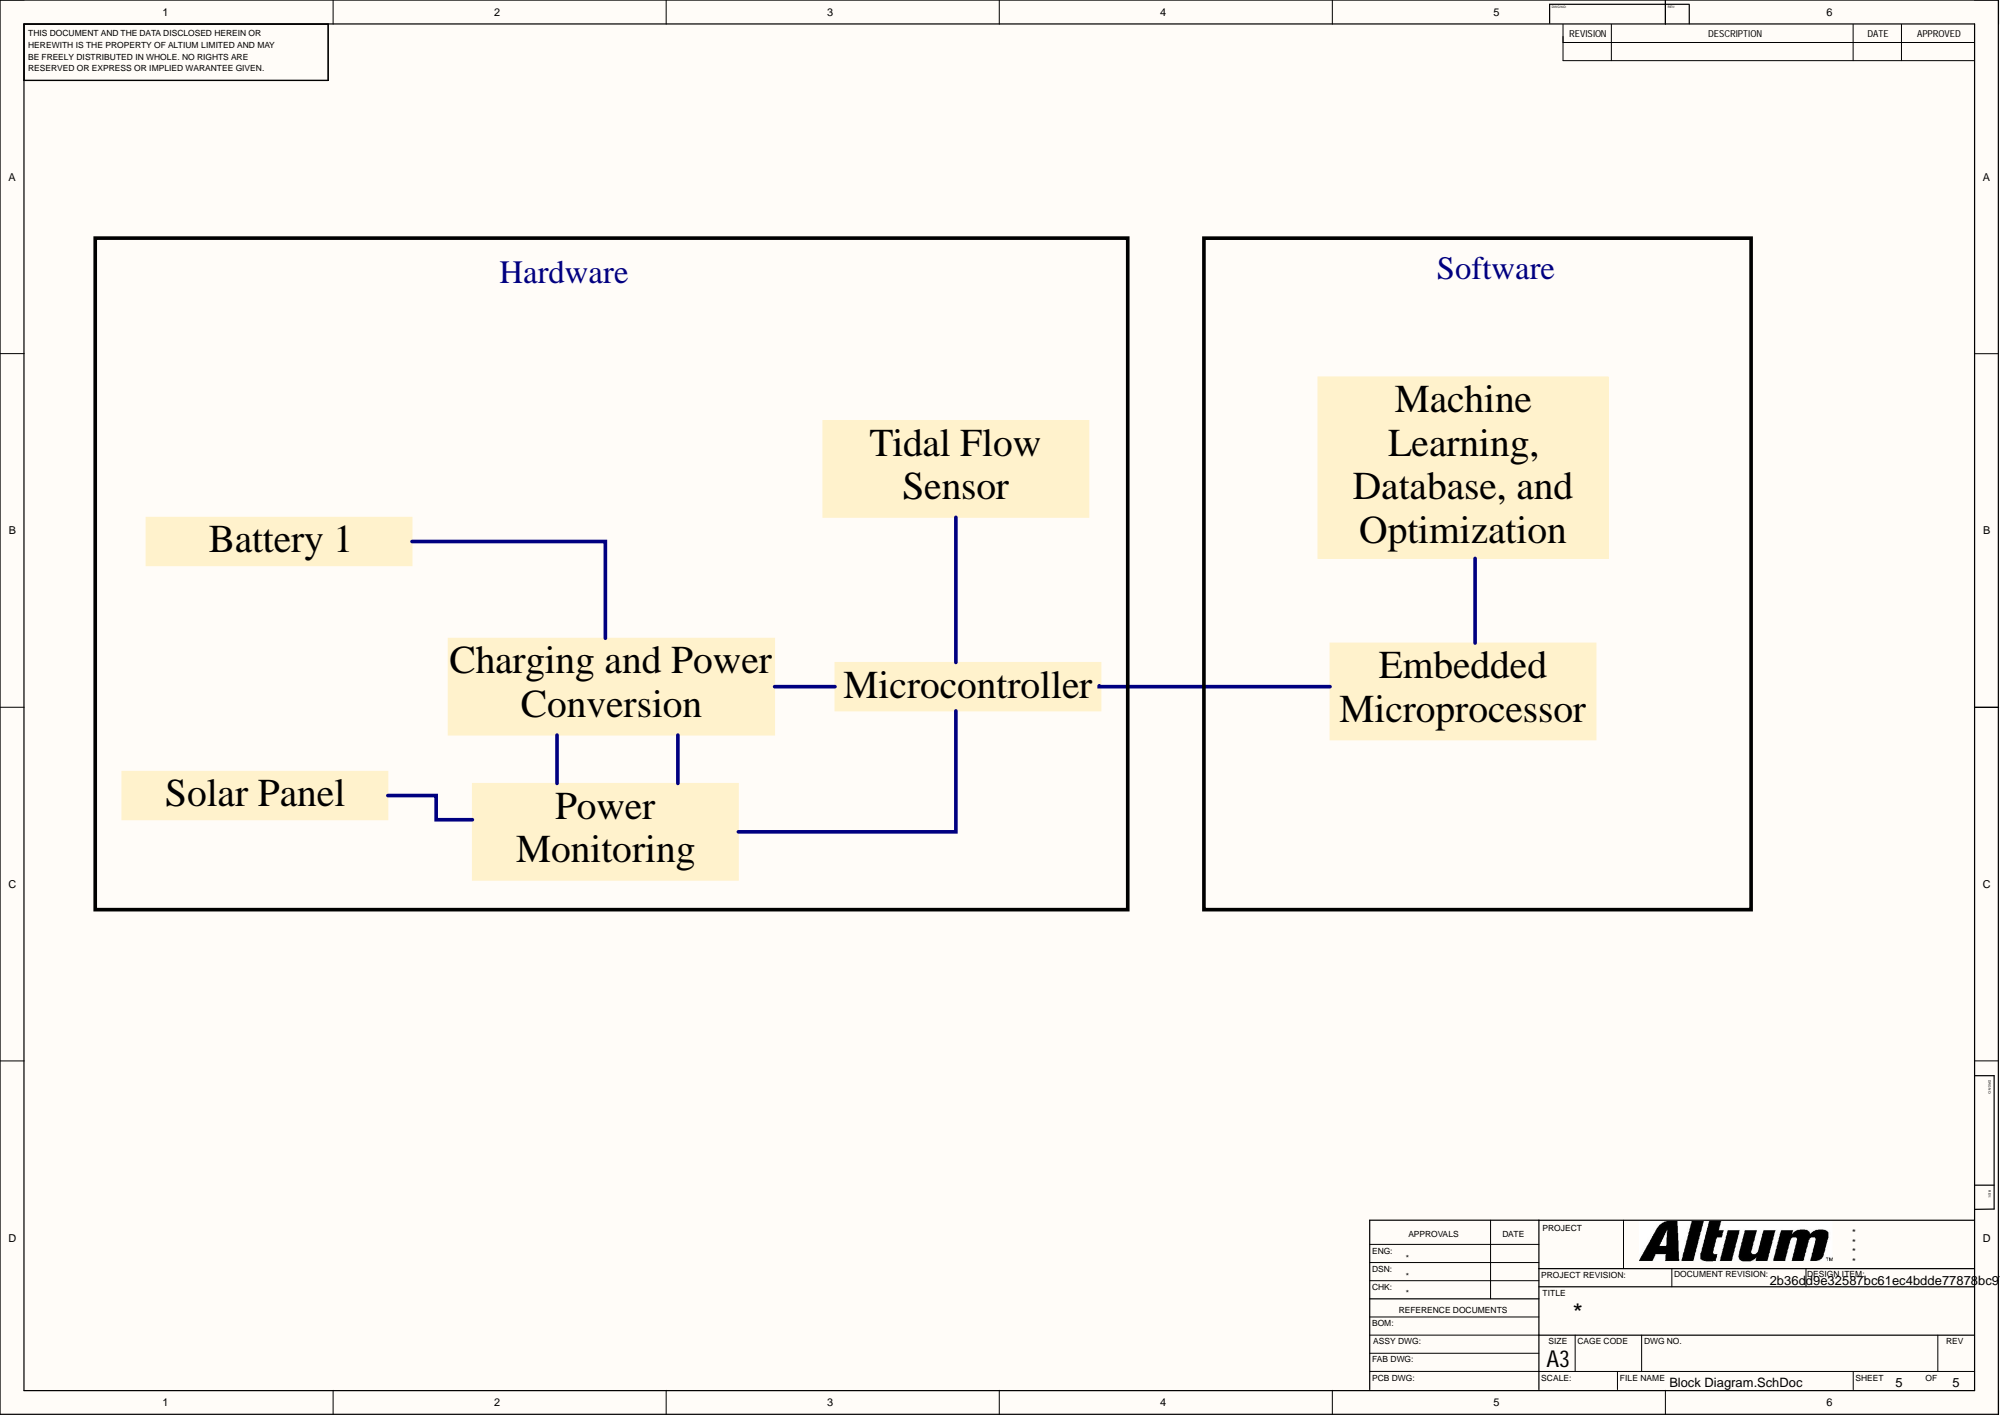
[picture p27: page 5]

DWG NO: | REV:

THIS DOCUMENT AND THE DATA DISCLOSED HEREIN OR HEREWITH IS THE PROPERTY OF ALTIUM LIMITED AND MAY BE FREELY DISTRIBUTED IN WHOLE. NO RIGHTS ARE RESERVED OR EXPRESS OR IMPLIED WARANTEE GIVEN. | | REVISION | DESCRIPTION | DATE | APPROVED

DATE | PROJECT | * * APPROVALS * *

ENG: *

DSN: *

PROJECT REVISION: | DOCUMENT REVISION: | DESIGN ITEM:

CHK: *
