JuliusC4es4r/Intelligent-Tidal-Energy-Monitoring-System/(list of files, drawings)

Other design files:
Electrical/Block Diagram.SchDoc
Electrical/Intelligent Tidal Energy Monitoring System.PrjPcb
Electrical/ITEMS PCB Rev A.PcbDoc
Electrical/Master.SchDoc
Electrical/Microcontroller.SchDoc
Electrical/Power.SchDoc
Electrical/Sensors.SchDoc
PSpice/ECE 356 hardware.dsn
PSpice/ECE 356 hardware.opj
