JuliusC4es4r/Intelligent-Tidal-Energy-Monitoring-System/Firmware/MQTT.py

def connect():
  global client_id, mqtt_server, topic_sub
  client = MQTTClient(client_id, mqtt_server)
  client.connect()
  print('Connected to %s MQTT broker', (topic_sub))
  return client

def restart_and_reconnect():
  print('Failed to connect to MQTT broker. Reconnecting...')
  time.sleep(10)
  machine.reset()

try:
  client = connect()
except OSError as e:
  restart_and_reconnect()

while True:
  try:
    client.check_msg()
    if (time.time() - last_message) > message_interval:
      msg = 'Carter sucks :P #%d' % counter
      print('Connected to %s MQTT broker, subscribed to %s topic' % (mqtt_server, topic_pub))
      client.publish(topic_pub, msg)
      last_message = time.time()
      counter += 1
  except OSError as e:
    restart_and_reconnect()
