JuliusC4es4r/Intelligent-Tidal-Energy-Monitoring-System/(commit log)

2022-09-14 Initial Commit and Setup of Repo
    [ITEMS PCB Rev A.PcbDoc, Intelligent Tidal Energy Monitoring System.PrjPcb, Master.SchDoc, Microcontroller.SchDoc, Power.SchDoc, Sensors.SchDoc, USB Communication.SchDoc]
2022-09-15 1st draft of usb comm schematics
    added block diagram
    [Block Diagram.SchDoc, Intelligent Tidal Energy Monitoring System.PrjPcb, Master.SchDoc, Microcontroller.SchDoc, Power.SchDoc, USB Communication.SchDoc]
2022-09-16 Added new block diagram
    [Block Diagram.SchDoc]
2022-09-18 Cleaned up schematics
    [Intelligent Tidal Energy Monitoring System.PrjPcb, Microcontroller.SchDoc, USB Communication.SchDoc]
2022-09-20 First draft of power page
    [Intelligent Tidal Energy Monitoring System.PrjPcb, Master.SchDoc, Power.SchDoc, Sensors.SchDoc, USB Communication.SchDoc]
2022-09-22 Added mounting holes and flow sensor
    [Master.SchDoc, Power.SchDoc, Sensors.SchDoc]
2022-10-02 Added micro with reset, current sense, voltage ADC divider, GPS header
    [Microcontroller.SchDoc, Power.SchDoc, Sensors.SchDoc]
2022-10-02 Revisions after meeting with carter
    [Intelligent Tidal Energy Monitoring System.PrjPcb, Master.SchDoc, Microcontroller.SchDoc, Power.SchDoc, Sensors.SchDoc]
2022-10-03 Added switches diode and new resistors for outputting 5V5
    [ECE 356 hardware.dsn, ECE 356 hardware.opj, Power.SchDoc]
2022-10-03 buffers, labelling, breakout pins, charge control, small changes
    [Master.SchDoc, Microcontroller.SchDoc, Power.SchDoc, Sensors.SchDoc]
2022-10-03 broke out all pins
    [Microcontroller.SchDoc]
2022-10-04 Added output job file and BOM
    also added 1 TP
    [Bill of Materials-Intelligent Tidal Energy Monitoring System(ITEMS PCBA Rev A).xlsx, Intelligent Tidal Energy Monitoring System.PrjPcb, Microcontroller.SchDoc]
2022-10-05 Imported components into pcb and fixed rpi pico footprint problem
    [ITEMS PCB Rev A.PcbDoc, Microcontroller.SchDoc, RPi_Pico.PcbLib, RPi_Pico.SchLib]
2022-10-06 Annotated Schematics and updated PCB
    [ITEMS PCB Rev A.PcbDoc, Intelligent Tidal Energy Monitoring System.PrjPcb, Master.SchDoc, Microcontroller.SchDoc, Power.SchDoc, Sensors.SchDoc]
2022-10-07 Added mechanical components and initial draft of PCB
    [4-Pin Header - Female - 2.54mm.step, 4-Pin Header - Male - 2.54mm.step, A_GPS_main.SLDPRT, ECE 356 hardware.opj, ITEMS PCB Rev A.PcbDoc, Intelligent Tidal Energy Monitoring System.PrjPcb, Microcontroller.SchDoc, Power.SchDoc]
2022-10-08 Worked on pcb layout more
    [ITEMS PCB Rev A.PcbDoc, Sensors.SchDoc]
2022-10-11 Continued pcb layout
    [ITEMS PCB Rev A.PcbDoc, Sensors.SchDoc]
2022-10-12 Almost done PCB
    [Power.SchDoc, Sensors.SchDoc]
2022-10-13 PCB complete and added solidworks cad models
    [ITEMS Assembly.SLDASM, ITEMS Bottom Case.SLDPRT, ITEMS PCBA.SLDASM, Intelligent Tidal Energy Monitoring System.PrjPcb, Microcontroller.SchDoc, Sensors.SchDoc, Solar Panel.SLDPRT]
2022-10-14 Added GPS heatsets
    [91290A111_Alloy Steel Socket Head Screw.SLDPRT, 94459A140_Heat-Set Inserts for Plastic (1).SLDPRT, ITEMS Bottom Case.SLDPRT, ITEMS PCBA.SLDASM]
2022-10-16 Outjob file update
    [Bill of Materials-Intelligent Tidal Energy Monitoring System(ITEMS PCBA Rev A).xlsx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]
2022-10-16 updated bom
    [Bill of Materials-Intelligent Tidal Energy Monitoring System(ITEMS PCBA Rev A).xlsx]
2022-10-16 Gerber export
    [ITEMS PCB Rev A.GBL, ITEMS PCB Rev A.GBO, ITEMS PCB Rev A.GBP, ITEMS PCB Rev A.GBS, ITEMS PCB Rev A.GKO, ITEMS PCB Rev A.GM1, ITEMS PCB Rev A.GTL, ITEMS PCB Rev A.GTO]
2022-10-20 removing some sldparts
    [Intelligent Tidal Energy Monitoring System.PrjPcb]
2022-11-04 Added mech stuff for holding flow sensors
    [5972K222_Ball Bearing.SLDPRT, Flow Sensor Mount.SLDPRT, Flow Sensor Mount.STL, Flow Sensor RotatorSLDPRT.SLDPRT, Flow Sensor RotatorSLDPRT.STL, ITEMS Bottom Case.SLDPRT, ITEMS Bottom Case.STL, ITEMS Flow Sensor Assembly.SLDASM]
2022-11-06 updated flow sensor parts
    [Flow Sensor RotatorSLDPRT.SLDPRT, Flow Sensor RotatorSLDPRT.STL]
2022-11-21 Completed flow sensor code
2022-12-03 parsing and db insertion sample for copy
